Nitrokey/nitrokey-fido-u2f-hardware/export settings.png

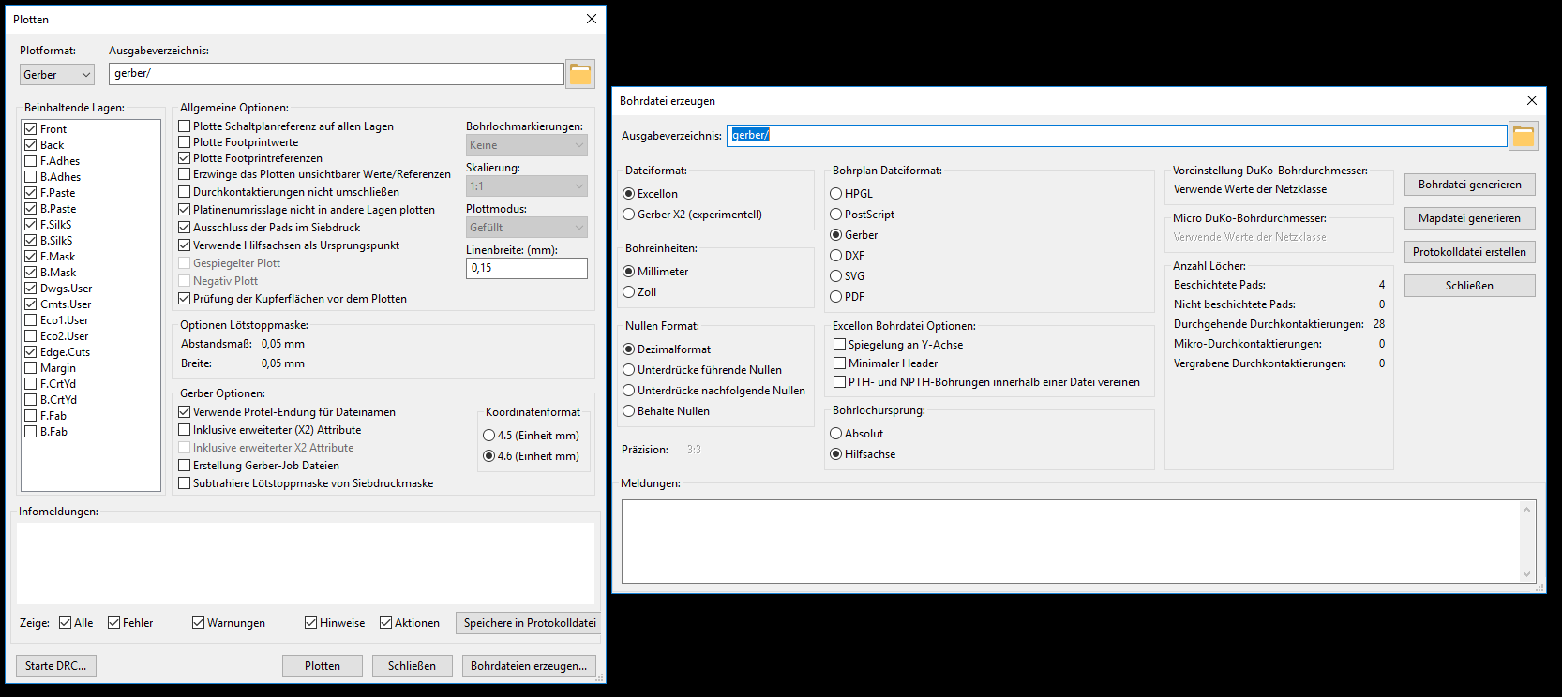
export settings.png
