Nitrokey/nitrokey-fido-u2f-hardware/nk-u2f-Schematics.pdf

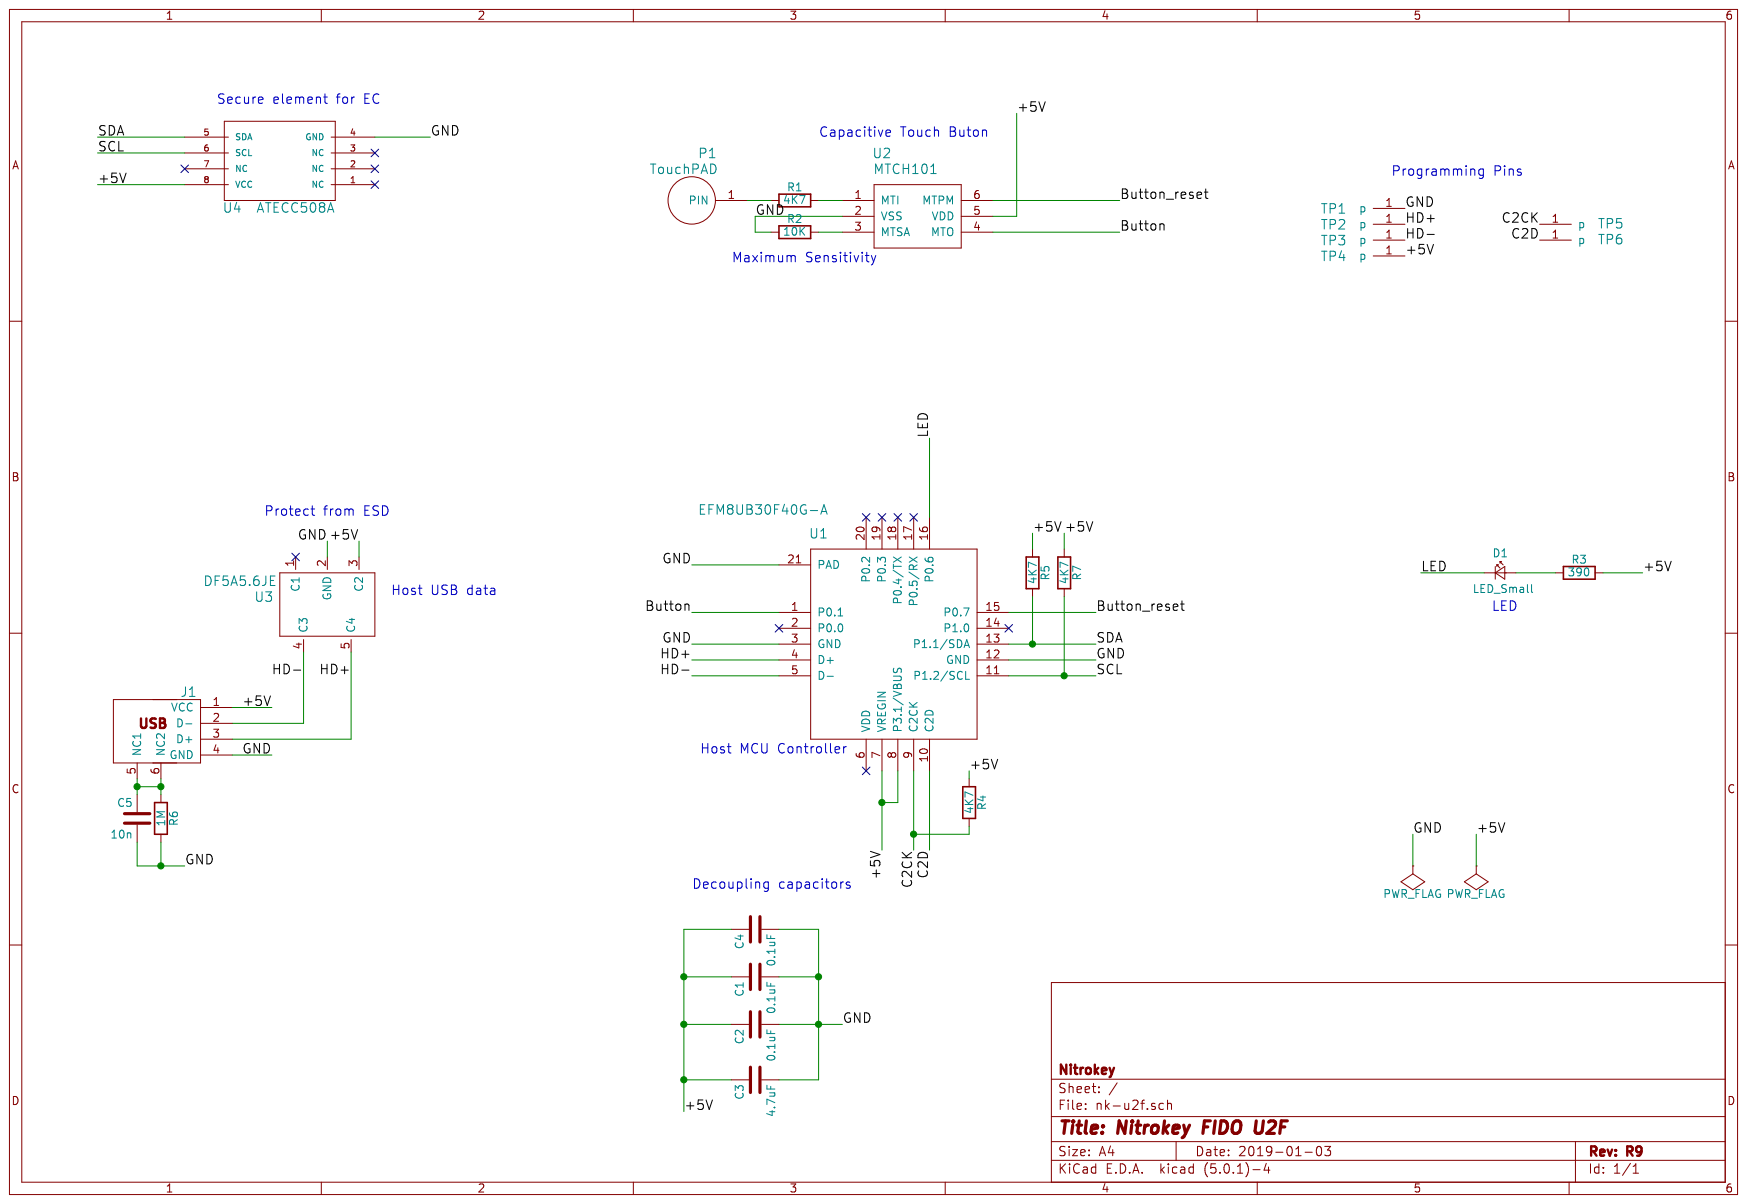
[picture p2: page 1]
