Nitrokey/nitrokey-fido-u2f-hardware/assembly/BOT_Assembly.pdf

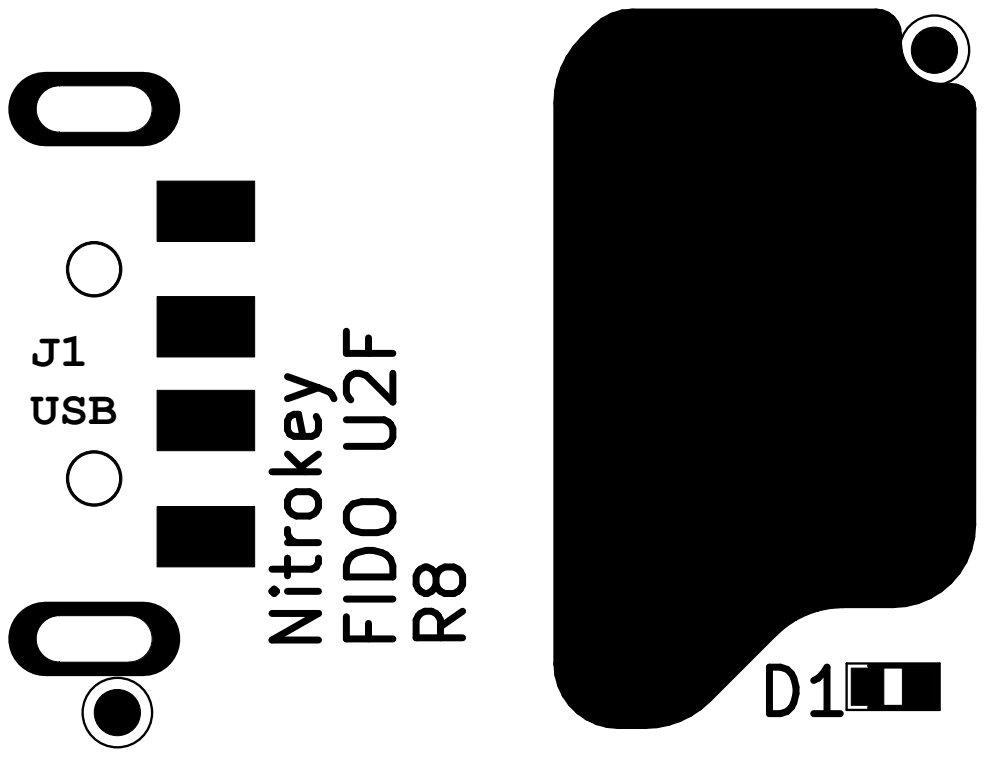
[picture p3: page 1]
