Nitrokey/nitrokey-fido-u2f-hardware/assembly/TOP_Assembly.pdf

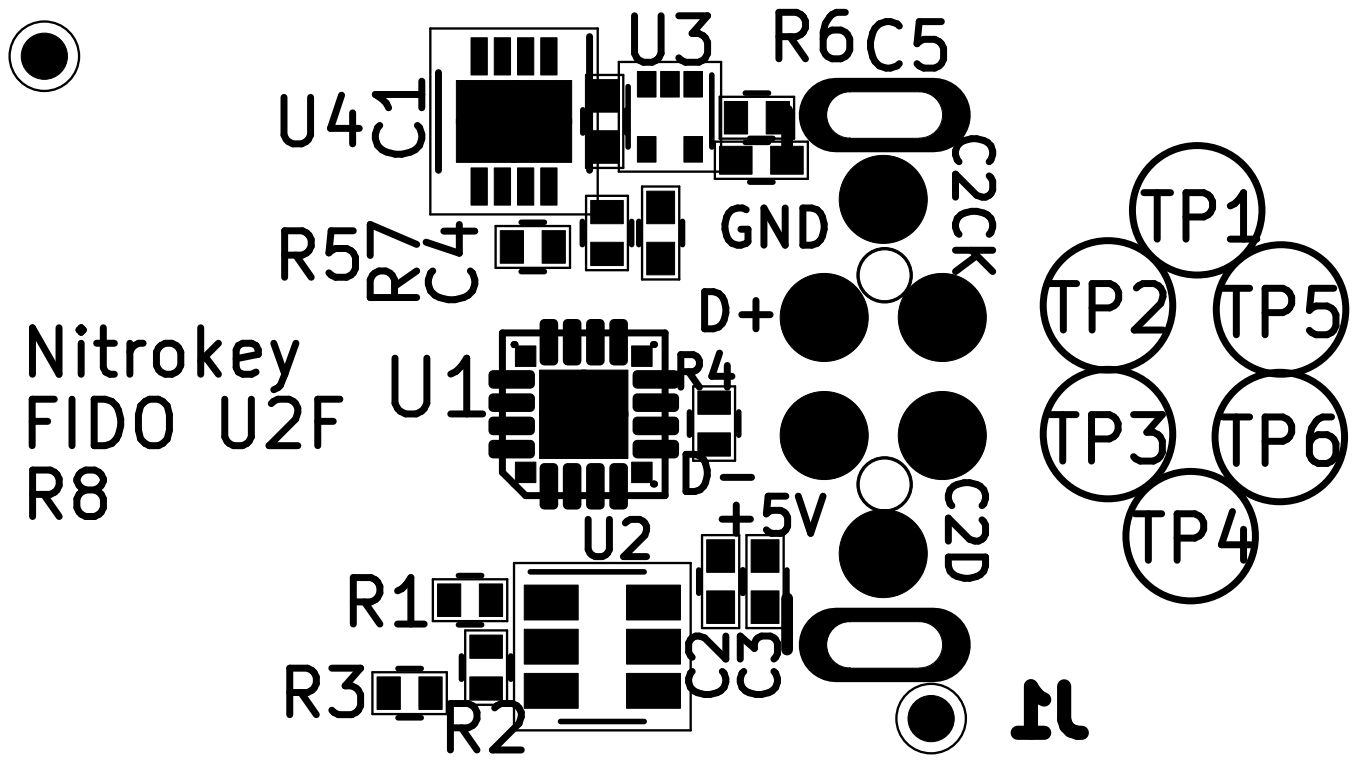
[picture p4: page 1]
