Nitrokey/nitrokey-fido-u2f-hardware/(threads)

Thread 5 (2018-08-24):

Missing datasheets (esp. for touch button controller)

szszszsz, 2018-08-24:
In the [datasheets directory](https://github.com/Nitrokey/nitrokey-fido-u2f-hardware/tree/master/hardware/datasheets) there is no document regarding touch button, and it misses other as well.

- [ ] Add EFM8UB30 Reference Manual
- [ ] Add touch button controller
- [ ] Remove RGB LED datasheet, potentially replace with current one

szszszsz, 2018-08-24:
Touch button: http://ww1.microchip.com/downloads/en/DeviceDoc/40001664B.pdf

Closed 2019-03-01.
