Nitrokey/nitrokey-fido-u2f-hardware/(commit log)

2017-03-03 Updated Design with Touch Pad
    Push Button updated with Capacitive touch.
    MCU package changed to QFN20
    Secure memory package changed
    [U2F_Zero.kicad_pcb, U2F_Zero.sch]
2017-03-03 unused file remoed
    [u2f-zero-panel.kicad_pcb, u2f-zero.csv, u2f-zero.kicad_pcb, u2f-zero.sch]
2017-03-07 PCB layout Updated
    All resistors capacitors and LED are 0402 packages.
    Programming headeder updated.
    [U2F_Zero.kicad_pcb, nk-u2f.kicad_pcb, nk-u2f.sch]
2017-03-08 BOM Added with all part details
    BOM Added with all part details
    [nk-u2f-BOM.xlsx]
2017-03-21 Schematics updated
2017-06-13 Gerber files added
    [nk-u2f-B.Mask.gbs, nk-u2f-B.Paste.gbp, nk-u2f-B.SilkS.gbo, nk-u2f-Back.gbl, nk-u2f-Edge.Cuts.gm1, nk-u2f-F.Mask.gts, nk-u2f-F.Paste.gtp, nk-u2f-F.SilkS.gto]
2017-06-13 Gerber file folder moved in Hardware.
    [nk-u2f-B.Mask.gbs, nk-u2f-B.Paste.gbp, nk-u2f-B.SilkS.gbo, nk-u2f-Back.gbl, nk-u2f-Edge.Cuts.gm1, nk-u2f-F.Mask.gts, nk-u2f-F.Paste.gtp, nk-u2f-F.SilkS.gto]
2017-06-13 Touch Pad senitivity updated
    Touch Pad senitivity updated
    Programming pads updated to compatible with protoboard pitch
    [nk-u2f-BOM.xlsx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]
2017-06-15 fabrication files
    [nk-u2f.csv, u2f-zero-case .stl, u2f-zero-case v16.iges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]
2017-06-22 Programming pads updated
    Programming pads for USB and C2 interface updated as segested for CNC
    programming
    [nk-u2f.kicad_pcb]
2017-06-23 GERBER files
    GERBER files generated in "GERBER" foler
    [nk-u2f-B.Mask.gbs, nk-u2f-B.Paste.gbp, nk-u2f-B.SilkS.gbo, nk-u2f-Back.gbl, nk-u2f-Edge.Cuts.gm1, nk-u2f-F.Mask.gts, nk-u2f-F.Paste.gtp, nk-u2f-F.SilkS.gto]
2017-06-23 Gerber File update
    Update GERBER files with 0.05mm solder mask clearance
    [nk-u2f-B.Mask.gbs, nk-u2f-B.Paste.gbp, nk-u2f-B.SilkS.gbo, nk-u2f-Back.gbl, nk-u2f-Edge.Cuts.gm1, nk-u2f-F.Mask.gts, nk-u2f-F.Paste.gtp, nk-u2f-F.SilkS.gto]
2018-01-14 Gerber and other generated files updated
    [nk-u2f-B.Mask.gbs, nk-u2f-B.Paste.gbp, nk-u2f-B.SilkS to vendor.gbo, nk-u2f-B.SilkS.gbo, nk-u2f-Back.gbl, nk-u2f-Edge.Cuts.gm1, nk-u2f-F.Mask.gts, nk-u2f-F.Paste.gtp]
2018-03-19 REV4
    GND plane has been added under the touch pad as a shield to block
    sensing beneath the board.
    [nk-u2f-B.Mask.gbs, nk-u2f-B.Paste.gbp, nk-u2f-B.SilkS.gbo, nk-u2f-Back.gbl, nk-u2f-Edge.Cuts.gm1, nk-u2f-F.Mask.gts, nk-u2f-F.Paste.gtp, nk-u2f-F.SilkS.gto]
2018-03-19 REV4
    R6, R8, and their tracks have been deleted.
    GND planes refilled.
    TOP, BOT pdfs have been refreshed.
    [nk-u2f-B.Mask.gbs, nk-u2f-B.Paste.gbp, nk-u2f-B.SilkS.gbo, nk-u2f-Back.gbl, nk-u2f-Edge.Cuts.gm1, nk-u2f-F.Mask.gts, nk-u2f-F.Paste.gtp, nk-u2f-F.SilkS.gto]
2018-03-19 REV4
    Deletion of R6 and R8
    [nk-u2f.csv]
2018-03-25 Changes according to the original project description: - usb descriptors modified - gpio configuration modified - touch button requires a >=750ms long press - led functions changed
2018-05-23 REV5: - debug uart pads deleted - mcu replaced with EFM8UB30F40G-A-QFN20 (program memory upgrade 16->40kB)
    [nk-u2f-B.Mask.gbs, nk-u2f-B.Paste.gbp, nk-u2f-B.SilkS.gbo, nk-u2f-Back.gbl, nk-u2f-Edge.Cuts.gm1, nk-u2f-F.Mask.gts, nk-u2f-F.Paste.gtp, nk-u2f-F.SilkS.gto]
2018-08-17 REV6
    - USB connector footprint corrected
    - Revision number printed on board incremented to REV6
    [nk-u2f-B.Mask.gbs, nk-u2f-B.Paste.gbp, nk-u2f-B.SilkS.gbo, nk-u2f-Back.gbl, nk-u2f-Edge.Cuts.gm1, nk-u2f-F.Mask.gts, nk-u2f-F.Paste.gtp, nk-u2f-F.SilkS.gto]
2018-08-22 BOM correction: - 100nF cap. and 4,7k res. quantities corrected - unnecessary *.numbers format bom deleted
    [nk-u2f.csv]
2018-09-01 Deletion of unnecessary nk-u2f-B.SilkS to vendor.gbo silkscreen file
    [nk-u2f-B.SilkS to vendor.gbo]
2018-09-01 Add more clearance along the pcb outline near to U2
    - U2, R5 and R7 were moved away to keep more space between U2 and the pcb edge
    [nk-u2f-B.Mask.gbs, nk-u2f-B.Paste.gbp, nk-u2f-B.SilkS.gbo, nk-u2f-Back.gbl, nk-u2f-Edge.Cuts.gm1, nk-u2f-F.Mask.gts, nk-u2f-F.Paste.gtp, nk-u2f-F.SilkS.gto]
2018-09-01 Mechanical flashing harness removed and directory restructured
    [flashing_harness.FCStd, flashing_harness.stl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]
2018-09-19 U1 (MCU) Correction for production
    - Value field corrected to EFM8UB3x
    - Placement type set to SMD
    [nk-u2f.kicad_pcb]
2018-09-30 USB Chassis EMI filter added
    [nk-u2f-2018-09-30-00-03-31.sch, nk-u2f-2018-09-30-00-06-37.sch, nk-u2f.csv, nk-u2f.kicad_pcb]
2018-09-30 LED moved to the corner to be far away from the touch button
    [nk-u2f.kicad_pcb]
2018-09-30 Rearrange the surroundings of touch button pad tracks
    [nk-u2f.kicad_pcb]
2018-09-30 Fabrication data (gerber, pick&place)
    [nk-u2f-B.Mask.gbs, nk-u2f-B.Paste.gbp, nk-u2f-B.SilkS.gbo, nk-u2f-Back.gbl, nk-u2f-Edge.Cuts.gm1, nk-u2f-F.Mask.gts, nk-u2f-F.Paste.gtp, nk-u2f-F.SilkS.gto]
2018-10-29 Change R3 value 100->390
    [nk-u2f.csv, nk-u2f.sch]
2018-10-29 Deletion of rescue-backup folder and nk-u2f-rescue.* files
    [nk-u2f-2018-09-30-00-03-31.sch, nk-u2f-2018-09-30-00-06-37.sch]
2018-12-21 ticks added, larger touch sensor
    [nk-u2f-B.Mask.gbs, nk-u2f-B.Paste.gbp, nk-u2f-B.SilkS.gbo, nk-u2f-Back.gbl, nk-u2f-Edge.Cuts.gm1, nk-u2f-F.Mask.gts, nk-u2f-F.Paste.gtp, nk-u2f-F.SilkS.gto]
2019-01-06 R8 with marks, larger touch pad and components moved to backside
    [nk-u2f-B.Mask.gbs, nk-u2f-B.Paste.gbp, nk-u2f-B.SilkS.gbo, nk-u2f-Back.gbl, nk-u2f-Edge.Cuts.gm1, nk-u2f-F.Mask.gts, nk-u2f-F.Paste.gtp, nk-u2f-F.SilkS.gto]
2019-03-01 BOM added
    [nk-u2f.csv]
2019-05-22 paste corrected
    [nk-u2f.kicad_pcb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]
